helioz2000/StepAttenuator/ComponentData/Step_Att_Diminsions.pdf

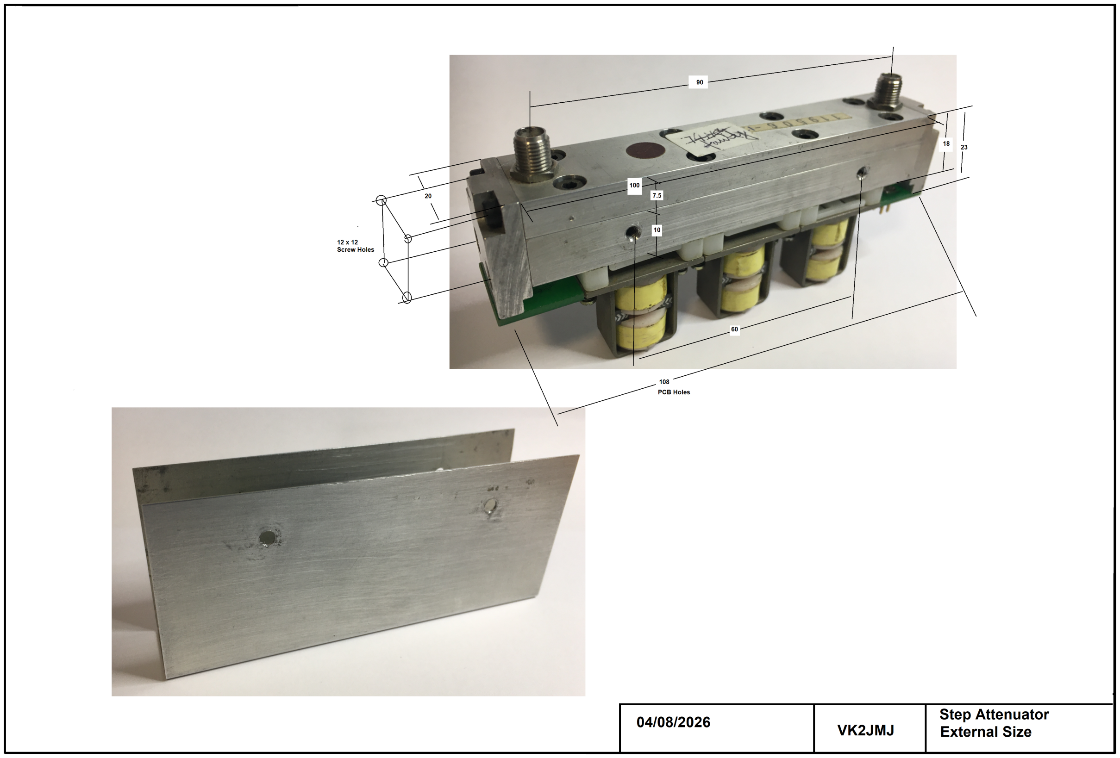
[picture p4: page 1]
