helioz2000/StepAttenuator/StepAttenuator_R0.1.pdf

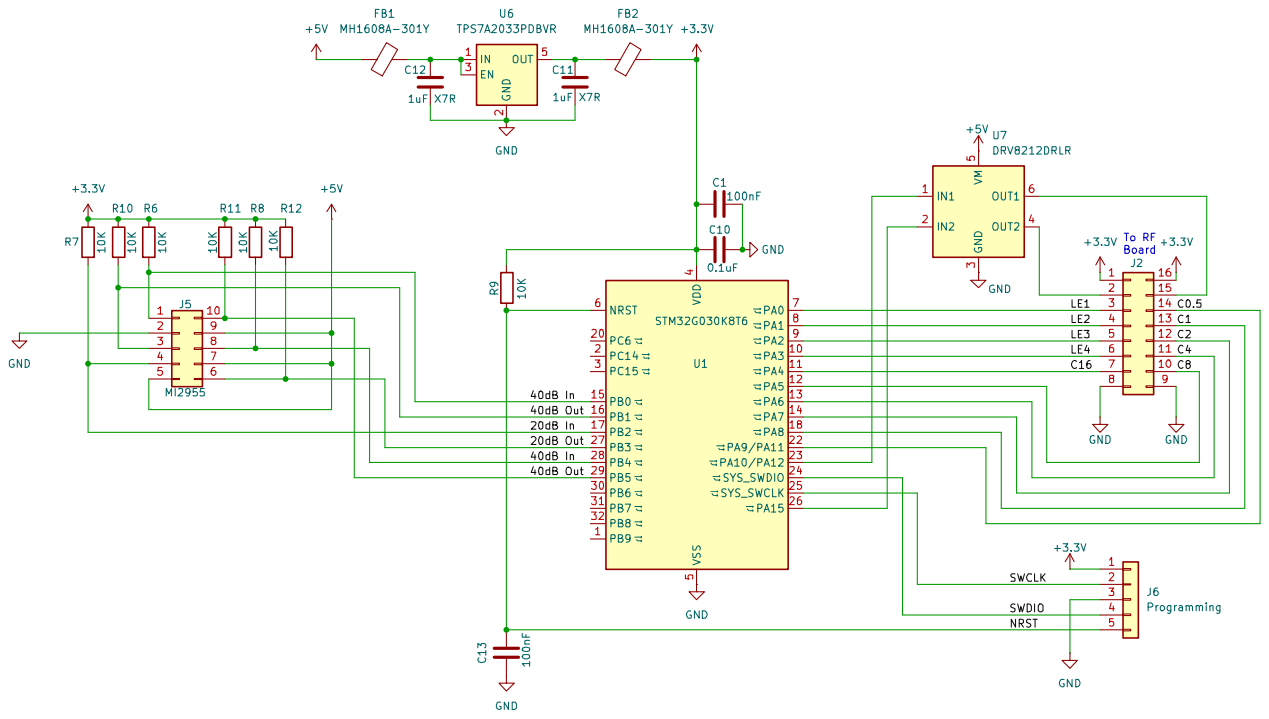
[picture p5: page 1]

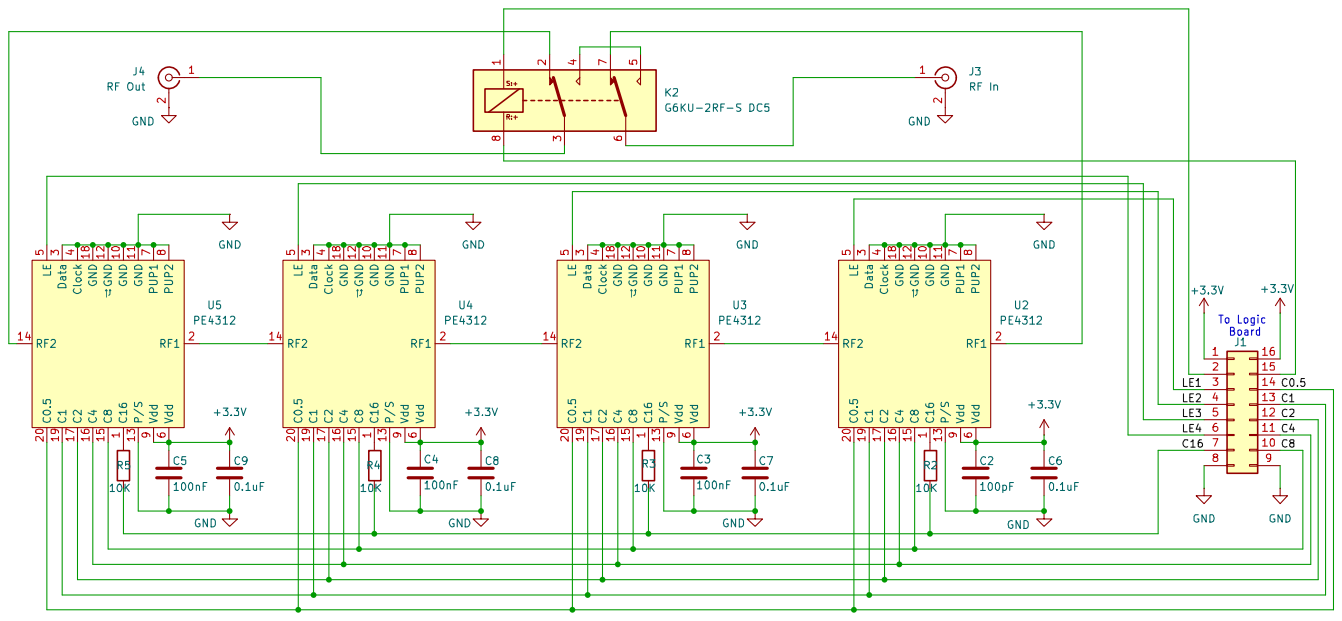
[picture p6: page 2]
