helioz2000/StepAttenuator/Doc/StepAttenuatorCircuit.pdf

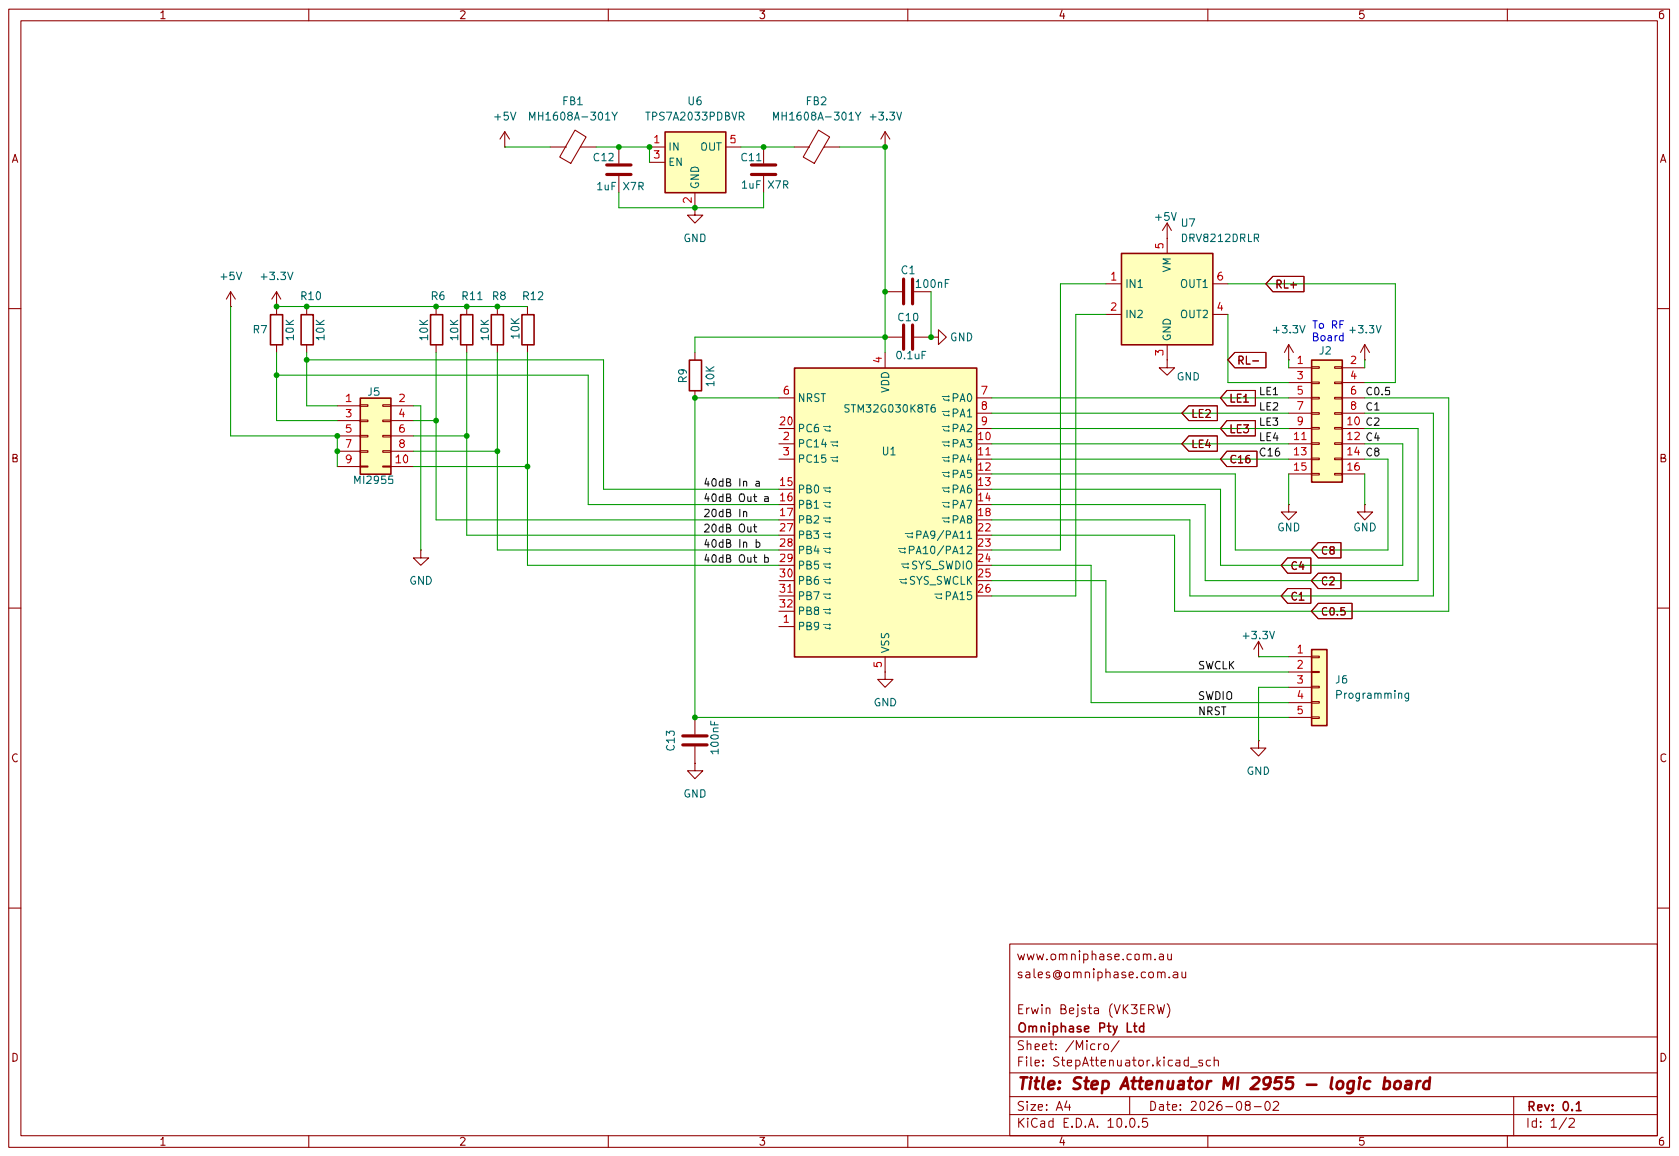
[picture p7: page 1]

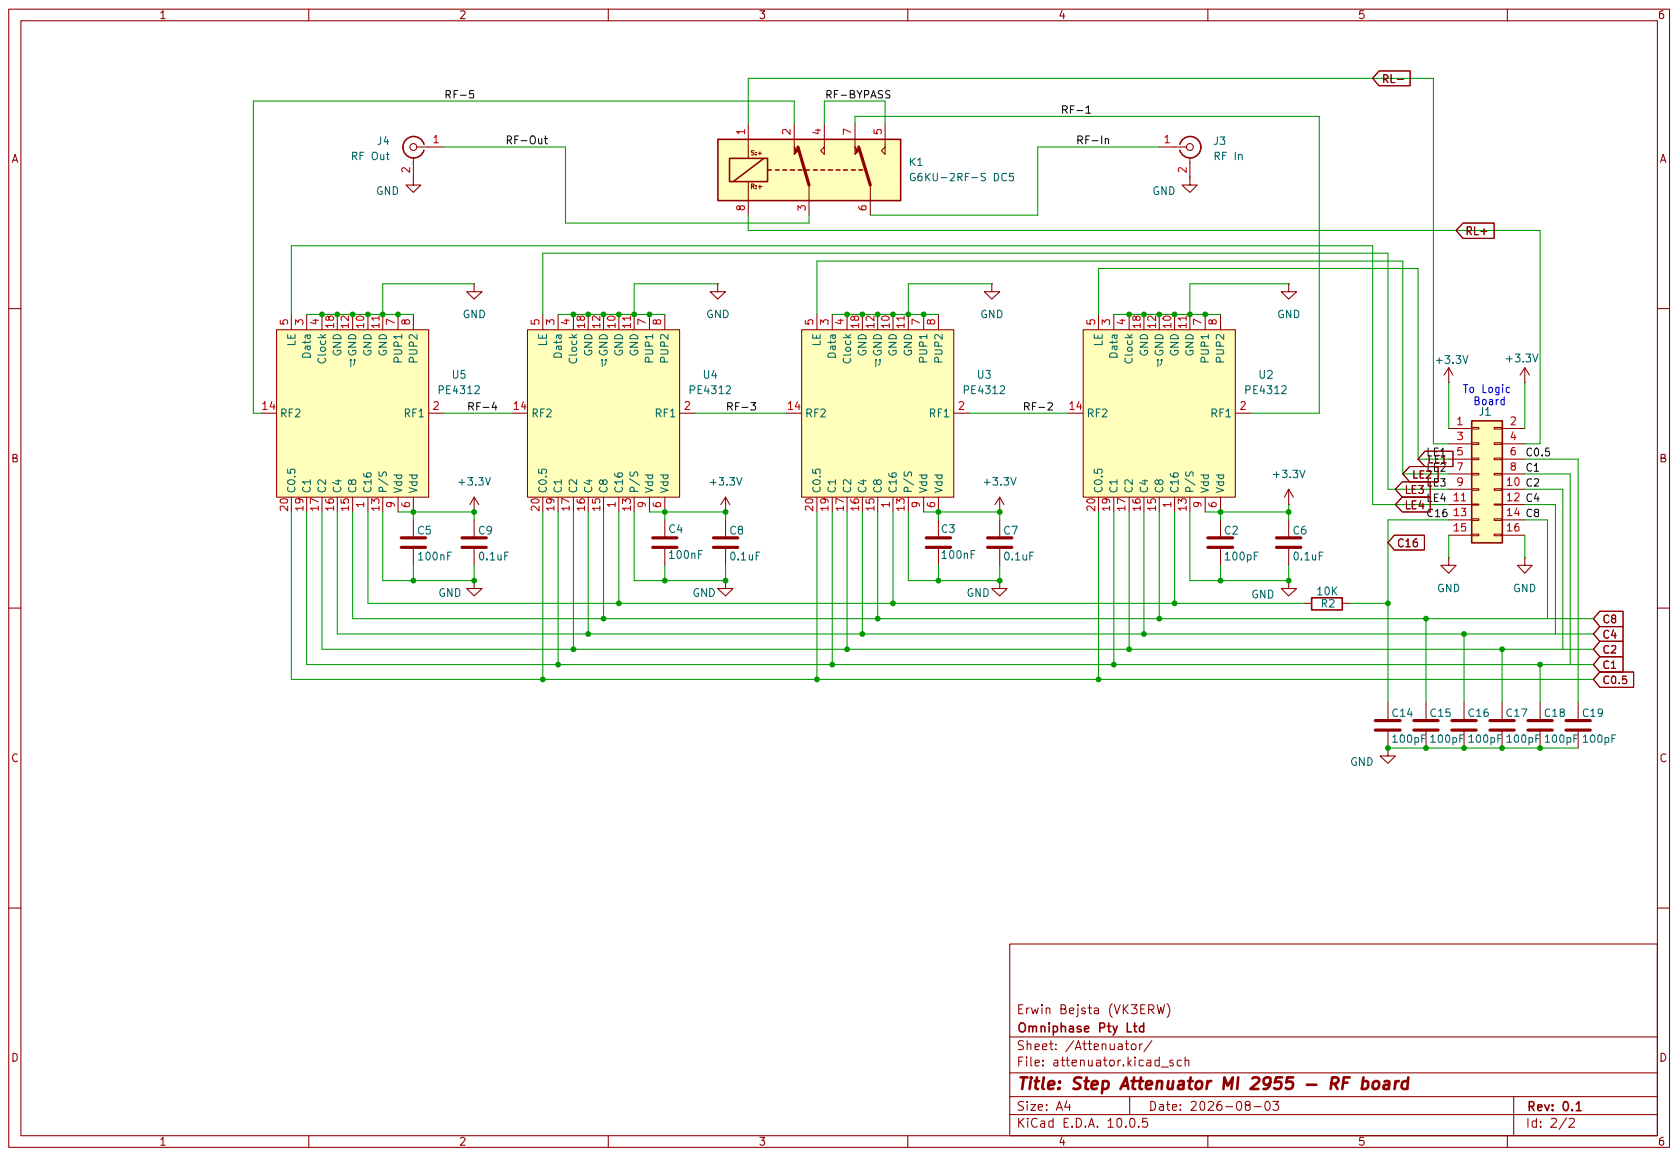
[picture p8: page 2]
