helioz2000/StepAttenuator/ComponentData/SMA_Amphenol.pdf

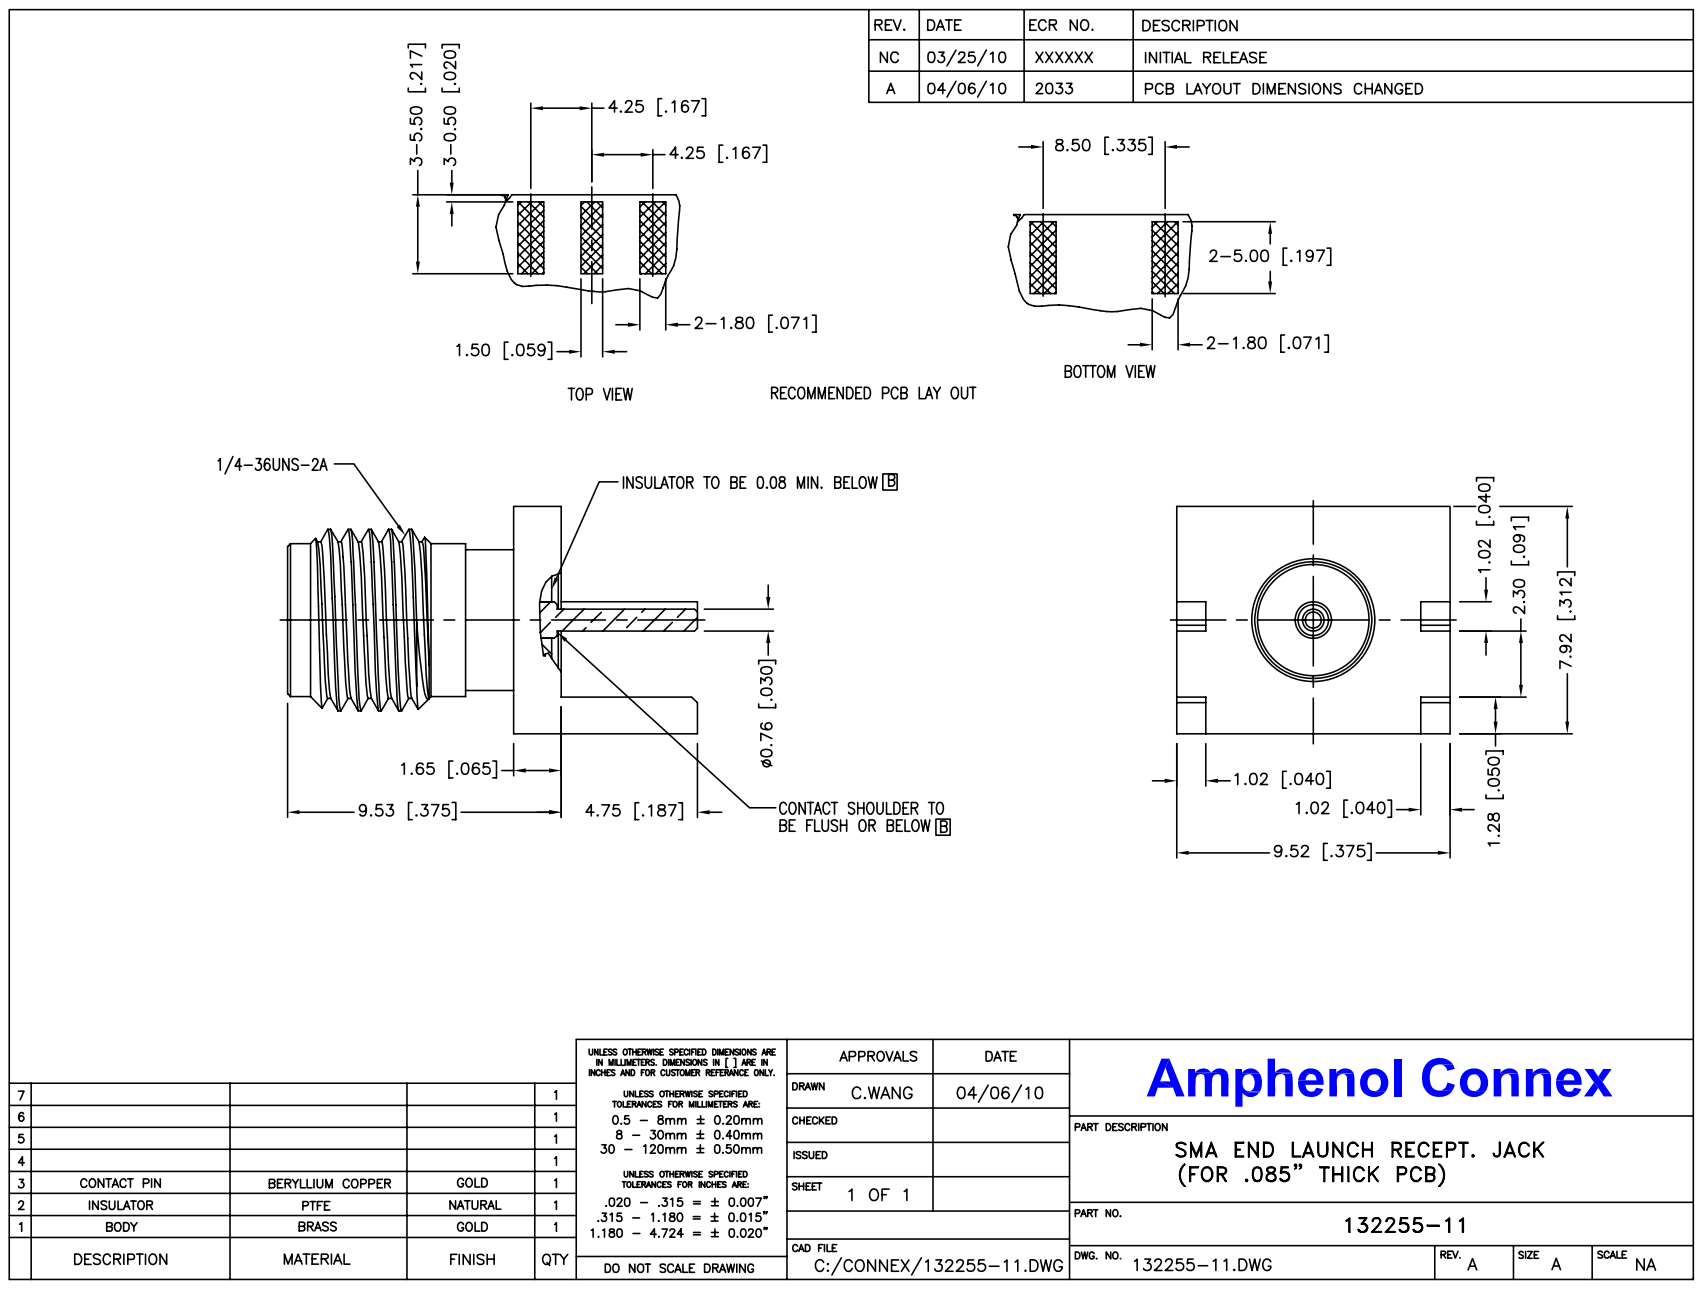
[picture p9: page 1]
