helioz2000/StepAttenuator/StepAttenuator.kicad_pcb

## KiCad design StepAttenuator.kicad_pcb (2026-10-29)

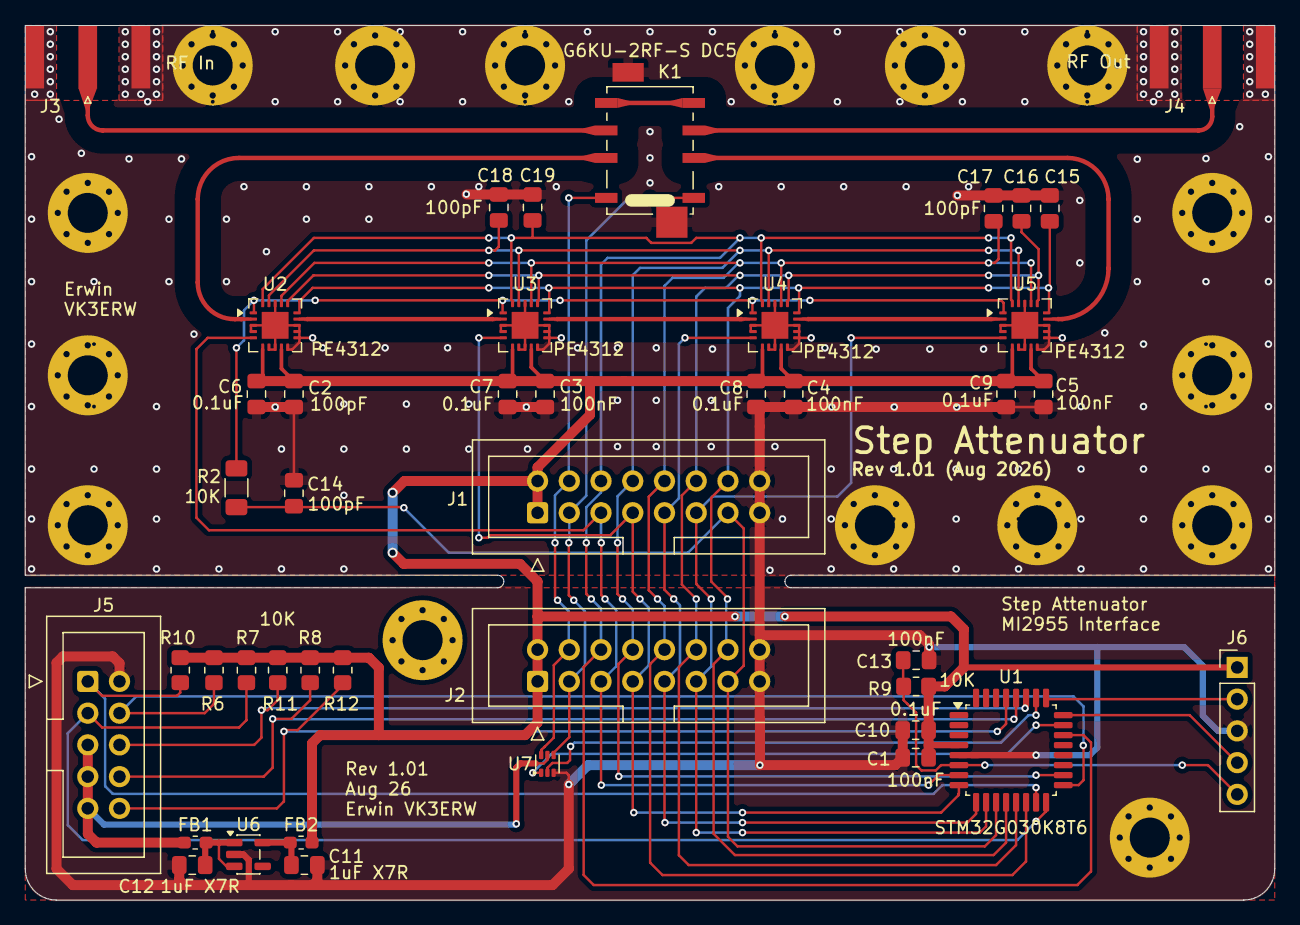
[picture p10: board StepAttenuator.kicad_pcb from above]

Board: 4 copper layers, 100.0 x 70.0 mm, 59 parts (0 on the bottom side), 37 nets.

Parts:
C1, C3, C4, C5, C13: 100nF; C_0805_2012Metric_Pad1.18x1.45mm_HandSolder
C2, C14, C15, C16, C17, C18, C19: 100pF; C_0805_2012Metric_Pad1.18x1.45mm_HandSolder
C6, C7, C8, C9, C10: 0.1uF; C_0805_2012Metric_Pad1.18x1.45mm_HandSolder
C11, C12: 1uF X7R; C_0805_2012Metric_Pad1.18x1.45mm_HandSolder
FB1, FB2: MH1608A-301Y; L_0603_1608Metric_Pad1.05x0.95mm_HandSolder
J1: IDC-Header_2x08_P2.54mm_Vertical
J2: Conn_02x08_Counter_Clockwise; IDC-Header_2x08_P2.54mm_Vertical
J3: RF In; SMA_Amphenol_132289_EdgeMount
J4: RF Out; SMA_Amphenol_132289_EdgeMount
J5: MI2955; IDC-Header_2x05_P2.54mm_Vertical
J6: Programming; PinHeader_1x05_P2.54mm_Vertical
K1: G6KU-2RF-S DC5; Relay_DPDT_Omron_G6K-2F-RF_special
M3, M3#2, M3#3, M3#4, M3#5, M3#6, M3#7, M3#8, M3#9, M3#10, M3#11, M4, M5, M6, M7, M8: MountingHole_3.2mm_M3_Pad_Via
R2: 10K; R_1206_3216Metric_Pad1.30x1.75mm_HandSolder
R6, R7, R8, R9, R10, R11, R12: 10K; R_0805_2012Metric_Pad1.20x1.40mm_HandSolder
U1: STM32G030K8T6; LQFP-32_7x7mm_P0.8mm
U2, U3, U4, U5: PE4312; QFN-20-1EP_4x4mm_P0.5mm_EP2x2mm
U6: TPS7A2033PDBVR; SOT-23-5
U7: DRV8212DRLR; SOT-563

Connections:
+3.3V: C1.1, C2.1, C3.1, C4.1, C5.1, C6.1, C7.1, C8.1, C9.1, C10.1, FB2.2, J1.1, J1.2, J2.1, J2.2, J6.1, R6.2, R7.2, R8.2, R9.1, R10.2, R11.2, R12.2, U1.4 (VDD), U2.6 (Vdd), U2.9 (Vdd), U3.6 (Vdd), U3.9 (Vdd), U4.6 (Vdd), U4.9 (Vdd), U5.6 (Vdd), U5.9 (Vdd)
+5V: FB1.1, J5.5, J5.7, J5.9, U7.5 (VM)
/Attenuator/RF-1: K1.7, U2.2 (RF1)
/Attenuator/RF-2: U2.14 (RF2), U3.2 (RF1)
/Attenuator/RF-3: U3.14 (RF2), U4.2 (RF1)
/Attenuator/RF-4: U4.14 (RF2), U5.2 (RF1)
/Attenuator/RF-5: K1.2, U5.14 (RF2)
/Attenuator/RF-BYPASS: K1.4, K1.5
/Attenuator/RF-In: J3.1 (In), K1.6
/Attenuator/RF-Out: J4.1 (In), K1.3
/Micro/20dB In: J5.4, R6.1, U1.17 (PB2)
/Micro/20dB Out: J5.6, R11.1, U1.27 (PB3)
/Micro/40dB In a: J5.1, R10.1, U1.15 (PB0)
/Micro/40dB In b: J5.8, R8.1, U1.28 (PB4)
/Micro/40dB Out a: J5.3, R7.1, U1.16 (PB1)
/Micro/40dB Out b: J5.10, R12.1, U1.29 (PB5)
/Micro/NRST: C13.2, J6.5, R9.2, U1.6 (NRST)
/Micro/SWCLK: J6.2, U1.25 (SYS_SWCLK)
/Micro/SWDIO: J6.4, U1.24 (SYS_SWDIO)
C0.5: C19.1, J1.6, J2.6, U1.22 (PA9/PA11), U2.20 (C0.5), U3.20 (C0.5), U4.20 (C0.5), U5.20 (C0.5)
C1: C18.1, J1.8, J2.8, U1.18 (PA8), U2.19 (C1), U3.19 (C1), U4.19 (C1), U5.19 (C1)
C2: C17.1, J1.10, J2.10, U1.14 (PA7), U2.17 (C2), U3.17 (C2), U4.17 (C2), U5.17 (C2)
C4: C16.1, J1.12, J2.12, U1.13 (PA6), U2.16 (C4), U3.16 (C4), U4.16 (C4), U5.16 (C4)
C8: C15.1, J1.14, J2.14, U1.12 (PA5), U2.15 (C8), U3.15 (C8), U4.15 (C8), U5.15 (C8)
C16: C14.1, J1.13, J2.13, R2.2, U1.11 (PA4)
GND: C1.2, C2.2, C3.2, C4.2, C5.2, C6.2, C7.2, C8.2, C9.2, C10.2, C11.2, C12.2, C13.1, C14.2, C15.2, C16.2, C17.2, C18.2, C19.2, J1.15, J1.16, J2.15, J2.16, J3.2 (Ext), J4.2 (Ext), J5.2, J6.3, K1.9, M3.1, M3#2.1, M3#3.1, M3#4.1, M3#5.1, M3#6.1, M3#7.1, M3#8.1, M3#9.1, M3#10.1, M4.1, M5.1, M6.1, M7.1, M8.1, U1.5 (VSS), U2.3 (Data), U2.4 (Clock), U2.7 (PUP1), U2.8 (PUP2), U2.10 (GND), U2.11 (GND), U2.12 (GND), U2.13 (P/S), U2.18 (GND), U2.21, U3.3 (Data), U3.4 (Clock), U3.7 (PUP1), U3.8 (PUP2), U3.10 (GND), U3.11 (GND), U3.12 (GND), U3.13 (P/S), U3.18 (GND), U3.21, U4.3 (Data), U4.4 (Clock), U4.7 (PUP1), U4.8 (PUP2), U4.10 (GND), U4.11 (GND), U4.12 (GND), U4.13 (P/S), U4.18 (GND), U4.21, U5.3 (Data), U5.4 (Clock), U5.7 (PUP1), U5.8 (PUP2), U5.10 (GND), U5.11 (GND), U5.12 (GND), U5.13 (P/S), U5.18 (GND), U5.21, U6.2 (GND), U7.3 (GND)
LE1: J1.5, J2.5, U1.7 (PA0), U2.5 (LE)
LE2: J1.7, J2.7, U1.8 (PA1), U3.5 (LE)
LE3: J1.9, J2.9, U1.9 (PA2), U4.5 (LE)
LE4: J1.11, J2.11, U1.10 (PA3), U5.5 (LE)
unnamed: U1.23 (PA10/PA12), U7.1 (IN1)
unnamed: U1.26 (PA15), U7.2 (IN2)
unnamed: R2.1, U2.1 (C16), U3.1 (C16), U4.1 (C16), U5.1 (C16)
unnamed: C12.1, FB1.2, U6.1 (IN), U6.3 (EN)
unnamed: C11.1, FB2.1, U6.5 (OUT)
RL+: J1.4, J2.4, K1.8, U7.6 (OUT1)
RL-: J1.3, J2.3, K1.1, U7.4 (OUT2)
