helioz2000/StepAttenuator/STM32/StepAttenuator/Core/Src/main.c

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
/* Includes ------------------------------------------------------------------*/
#include "main.h"
#include "usart.h"
#include "gpio.h"

/* USER CODE BEGIN Includes */
#include <stdbool.h>
#include <stdio.h>
/* USER CODE END Includes */

/* USER CODE BEGIN PD */
#define PE4312_TIME 1	// [ms] delay between signal changes on the pads
#define SERVICE_SIGNAL_DEBOUNCE 200 // [ms] debounce time for Service Mode signals
/* USER CODE END PD */


/* USER CODE BEGIN PV */
// Volatile declaration for access in ISR and main program
volatile bool Att40A_state = false;
volatile bool Att40B_state = false;
volatile bool Att20_state = false;
volatile bool AttStateChanged = false;
volatile bool ServiceMode = false;				// Service mode for manual control
volatile bool ServiceModeInc = false;			// Service mode value increment
volatile bool ServiceModeDec = false;			// Service mode value decrement
volatile bool ServiceModeBypass = false;		// Service mode bypass enable
volatile bool ServiceModeBypassChanged = false;
bool ServicePE1 = false;
bool ServicePE2 = false;
bool ServicePE3 = false;
bool ServicePE4 = false;
int ServiceValue = 0;
volatile uint32_t ServiceLast_exti_time = 0;
/*
 * This matrix represents the attenuation settings for each of the 4 pad
 * in the attenuation circuit.
 * Power dissipation %age per pad is shown in line comments.
 * The maximum power dissipation per pad is +24dBm
 * At 100dB total attenuation the max input power to the
 * attenuator is +26.74dBm (472mW)
 *
 * NOTE: each attenuator pad has a typical insertion loss of 1.3dB (<1gHz) which
 * is taken into account in the below configuration. The attenuation
 * figures in brackets in the line comment represent attenuation
 * including the pad insertion losses
*/
const int ATTENUATOR_MATRIX[6][4] = {
    {  0,   0,   0,   0},  // 0dB: bypass via relay (total insertion loss of pads is 5.2dB)
    {  0,   5,  15, 130},  // 20.2dB  25.9%, 25.1%, 23.3%, 24.7% (1.3dB,1.8dB,2.8dB,14.3dB)
    {  0,  10,  30, 310},  // 40.2dB: 25.9%, 3.5%, 27.4%, 16.2% (1.3dB,2.3dB,4.3dB,32.3dB)
    {  5,  15, 220, 310},  // 60.2dB: 33.9%, 31.4%, 34.5%, 0.2% (1.8dB,2.8dB,23.3dB,32.3dB
    { 15, 105, 310, 310},  // 80.2dB: 47.5%, 49.7%, 2.7%, 0% (2.8dB,11.5dB,32.3dB,32.3dB)
    { 20, 310, 310, 310}   // 100.2dB: 53.2%, 46.7%, 0%, 0% (3.3dB,32.3dB,32.3dB,32.3dB)
/*	figures without pad insertion loss
    { 10,  15,  30, 145},  // 20dB  20.6%, 23.2%, 28%, 27.2%
    { 15,  25,  50, 310},  // 40dB: 29.2%, 31%, 27.2%, 12.6%
    { 15,  30, 245, 310},  // 60dB: 29.2%, 35.3%, 35.3%, 0.2%
    { 30, 150, 310, 310},  // 80dB: 49.9%, 48.5%, 1.6%, 0%
    { 70, 310, 310, 310}   // 100dB: 80%, 20%, 0%, 0%
*/
};

/* USER CODE END PV */

void SystemClock_Config(void);
/* USER CODE BEGIN 0 */

/**
  * @brief  Redirects standard output (printf) to the USART1 peripheral.
  * @param  file: Not used in this implementation.
  * @param  ptr: Pointer to the string buffer to transmit.
  * @param  len: Length of the string data to transmit.
  * @retval Number of characters transmitted.
  */
int _write(int file, char *ptr, int len)
{
  // External reference to the UART handle generated by CubeMX
  extern UART_HandleTypeDef huart1;

  // Transmit data over USART1 with a safe 100ms timeout window
  HAL_UART_Transmit(&huart1, (uint8_t*)ptr, len, 100);

  return len;
}

/**
 * @brief  Print service mode selected attenuator
 */
void print_service_mode_PE(void)
{
	if (ServicePE1) {
		printf("ATT1(U2)");
	} else if (ServicePE2){
		printf("ATT2(U3)");
	} else if (ServicePE3){
		printf("ATT3(U4)");
	} else if (ServicePE4){
		printf("ATT4(U5)");
	}
}

/**
 * @brief  Handle button interrupt in service mode
 */
void HAL_GPIO_EXTI_ServiceMode(uint16_t GPIO_Pin){
  uint32_t current_time = HAL_GetTick();
  // debounce service mode signals by ignoring signals for debounce time
  if ((current_time - ServiceLast_exti_time) < SERVICE_SIGNAL_DEBOUNCE) return;

  if (GPIO_Pin == ATT40A_IN_Pin)
  {
	ServiceModeInc = true;
  } else if (GPIO_Pin == ATT40A_OUT_Pin)
  {
	ServiceModeDec = true;
  } else if (GPIO_Pin == ATT20_IN_Pin)
  {
	ServiceModeBypass = !ServiceModeBypass;
	ServiceModeBypassChanged = true;
  }
  ServiceLast_exti_time = HAL_GetTick();
}

/**
 * @brief  Callback when attenuator setting inputs change
 */
void HAL_GPIO_EXTI_Falling_Callback(uint16_t GPIO_Pin)
{
  if (!ServiceMode) {
	if (GPIO_Pin == ATT40A_IN_Pin)
	{
		if (Att40A_state != true) AttStateChanged = true;
	    Att40A_state = true;
	} else if (GPIO_Pin == ATT40A_OUT_Pin)
	{
	    if (Att40A_state != false) AttStateChanged = true;
	    Att40A_state = false;
	} else if (GPIO_Pin == ATT20_IN_Pin)
	{
		if (Att20_state != true) AttStateChanged = true;
	    Att20_state = true;
	} else if (GPIO_Pin == ATT20_OUT_Pin)
	{
		if (Att20_state != false) AttStateChanged = true;
		Att20_state = false;
	} else if (GPIO_Pin == ATT40B_IN_Pin)
	{
		if (Att40B_state != true) AttStateChanged = true;
		Att40B_state = true;
	} else if (GPIO_Pin == ATT40B_OUT_Pin)
	{
		if (Att40B_state != false) AttStateChanged = true;
		Att40B_state = false;
	}
  } else {	// Service mode active
	  HAL_GPIO_EXTI_ServiceMode(GPIO_Pin);
  }
}

/**
 * @brief	Put MCU into stop mode until wake up by External Interrupt
 * @note	Upon wake up the MCU executes the ISR before code resumption
 */
void MCU_stop()
{
	/* Clear any pending flags and prepare for sleep */
	// It is good practice to wait for any signals to be fully released
	// so you don't instantly re-wake up from a lingering touch.
	HAL_Delay(500);

	/* ENTER DEEP SLEEP (STOP MODE) */
	/* This command drops current consumption to micro-amps.
       Execution pauses here until PB0-PB5 triggers an interrupt. */
	HAL_PWR_EnterSTOPMode(PWR_LOWPOWERREGULATOR_ON, PWR_STOPENTRY_WFI);

	/* When execution resumes after MCU stop, the interrupt service routine (ISR)
	 * will be executed before resuming execution at this point */

	/* IMPORTANT: RESTORE SYSTEM CLOCKS IMMEDIATELY AFTER WAKING UP */
	/* When waking from STOP mode, the STM32G0 always defaults back to
	   its internal HSI clock (16 MHz) and disables your high-speed PLL.
	   You must call this function to safely rebuild your clock tree back to
	   your configured speed (e.g., 64 MHz). */
	SystemClock_Config();

    /* Handle any post-wakeup operations */
	// Code here executes immediately after the clock is restored

}

/**
  * @brief  Set attenuator bypass relay
  * @param attValue: attenuator setpoint in dB
  */
void attenuator_bypass_relay(int attValue){
	//Switch relay into ON/OFF state
	if (attValue == 0) {
		HAL_GPIO_WritePin(RLY_ON_GPIO_Port, RLY_ON_Pin, GPIO_PIN_SET);
		HAL_GPIO_WritePin(RLY_OFF_GPIO_Port, RLY_OFF_Pin, GPIO_PIN_RESET);
	} else {
		HAL_GPIO_WritePin(RLY_ON_GPIO_Port, RLY_ON_Pin, GPIO_PIN_RESET);
		HAL_GPIO_WritePin(RLY_OFF_GPIO_Port, RLY_OFF_Pin, GPIO_PIN_SET);
	}
	// Time for relay to resume new position
	HAL_Delay(200);
	// The relay will stay in position without power
	HAL_GPIO_WritePin(RLY_ON_GPIO_Port, RLY_ON_Pin, GPIO_PIN_RESET);
	HAL_GPIO_WritePin(RLY_OFF_GPIO_Port, RLY_OFF_Pin, GPIO_PIN_RESET);
}

/**
  * @brief  Set attenuator value on parallel control lines
  * @param attValue: pad set point in dB x 10
  * @retval True on success
  */
// Pad attenuation range is 0-31.5dB in 0.5dB steps
bool attenuator_set_value(int attValue)
{
	// range check
	if ((attValue > 315) || (attValue < 0)) { return false; }
	int att = attValue;
	if (att >= 160) {
		HAL_GPIO_WritePin(C16_GPIO_Port, C16_Pin, GPIO_PIN_SET);
		att -= 160;
	} else {
		HAL_GPIO_WritePin(C16_GPIO_Port, C16_Pin, GPIO_PIN_RESET);
	}
	if (att >= 80) {
		HAL_GPIO_WritePin(C16_GPIO_Port, C8_Pin, GPIO_PIN_SET);
		att -= 80;
	} else {
		HAL_GPIO_WritePin(C16_GPIO_Port, C8_Pin, GPIO_PIN_RESET);
	}
	if (att >= 40) {
		HAL_GPIO_WritePin(C16_GPIO_Port, C4_Pin, GPIO_PIN_SET);
		att -= 40;
	} else {
		HAL_GPIO_WritePin(C16_GPIO_Port, C4_Pin, GPIO_PIN_RESET);
	}
	if (att >= 20) {
		HAL_GPIO_WritePin(C16_GPIO_Port, C2_Pin, GPIO_PIN_SET);
		att -= 20;
	} else {
		HAL_GPIO_WritePin(C16_GPIO_Port, C2_Pin, GPIO_PIN_RESET);
	}
	if (att >= 10) {
		HAL_GPIO_WritePin(C16_GPIO_Port, C1_Pin, GPIO_PIN_SET);
		att -= 10;
	} else {
		HAL_GPIO_WritePin(C16_GPIO_Port, C1_Pin, GPIO_PIN_RESET);
	}
	if (att >= 5) {
		HAL_GPIO_WritePin(C16_GPIO_Port, C05_Pin, GPIO_PIN_SET);
		att -= 5;
	} else {
		HAL_GPIO_WritePin(C16_GPIO_Port, C05_Pin, GPIO_PIN_RESET);
	}

    return true;
}

/**
  * @brief  Set attenuator pads to correct value
  * @param attValue: attenuator total attenuation in dB
  */
void attenuator_set_pads(int attValue) {
	// Possible values: 0, 20, 40, 60, 80, 100
	// Convert to array index 0,1,2,3,4,5
	int attIndex = attValue/20;
	// All latch signals off
	HAL_GPIO_WritePin(LE1_GPIO_Port, LE1_Pin, GPIO_PIN_RESET);
	HAL_GPIO_WritePin(LE2_GPIO_Port, LE2_Pin, GPIO_PIN_RESET);
	HAL_GPIO_WritePin(LE3_GPIO_Port, LE3_Pin, GPIO_PIN_RESET);
	HAL_GPIO_WritePin(LE4_GPIO_Port, LE4_Pin, GPIO_PIN_RESET);
	HAL_Delay(PE4312_TIME);

	// Attenuator Pad 1
	attenuator_set_value(ATTENUATOR_MATRIX[attIndex][0]);
	HAL_Delay(PE4312_TIME);
	// latch value into pad
	HAL_GPIO_WritePin(LE1_GPIO_Port, LE1_Pin, GPIO_PIN_SET);
	HAL_Delay(PE4312_TIME);
	HAL_GPIO_WritePin(LE1_GPIO_Port, LE1_Pin, GPIO_PIN_RESET);

	// Attenuator Pad 2
	attenuator_set_value(ATTENUATOR_MATRIX[attIndex][1]);
	HAL_Delay(PE4312_TIME);
	// latch value into pad
	HAL_GPIO_WritePin(LE2_GPIO_Port, LE2_Pin, GPIO_PIN_SET);
	HAL_Delay(PE4312_TIME);
	HAL_GPIO_WritePin(LE2_GPIO_Port, LE2_Pin, GPIO_PIN_RESET);

	// Attenuator Pad 3
	attenuator_set_value(ATTENUATOR_MATRIX[attIndex][2]);
	HAL_Delay(PE4312_TIME);
	// latch value into pad
	HAL_GPIO_WritePin(LE3_GPIO_Port, LE3_Pin, GPIO_PIN_SET);
	HAL_Delay(PE4312_TIME);
	HAL_GPIO_WritePin(LE3_GPIO_Port, LE3_Pin, GPIO_PIN_RESET);

	// Attenuator Pad 4
	attenuator_set_value(ATTENUATOR_MATRIX[attIndex][3]);
	HAL_Delay(PE4312_TIME);
	// latch value into pad
	HAL_GPIO_WritePin(LE4_GPIO_Port, LE4_Pin, GPIO_PIN_SET);
	HAL_Delay(PE4312_TIME);
	HAL_GPIO_WritePin(LE4_GPIO_Port, LE4_Pin, GPIO_PIN_RESET);
}

/**
  * @brief  Set attenuator pad service value on service pad
  */
void attenuator_set_service(void) {
	// All latch signals off
	HAL_GPIO_WritePin(LE1_GPIO_Port, LE1_Pin, GPIO_PIN_RESET);
	HAL_GPIO_WritePin(LE2_GPIO_Port, LE2_Pin, GPIO_PIN_RESET);
	HAL_GPIO_WritePin(LE3_GPIO_Port, LE3_Pin, GPIO_PIN_RESET);
	HAL_GPIO_WritePin(LE4_GPIO_Port, LE4_Pin, GPIO_PIN_RESET);
	HAL_Delay(PE4312_TIME);

	attenuator_set_value(ServiceValue);
	if (ServicePE1) {
		HAL_GPIO_WritePin(LE1_GPIO_Port, LE1_Pin, GPIO_PIN_SET);
		HAL_Delay(PE4312_TIME);
		HAL_GPIO_WritePin(LE1_GPIO_Port, LE1_Pin, GPIO_PIN_RESET);
	} else if (ServicePE2)
	{
		HAL_GPIO_WritePin(LE2_GPIO_Port, LE2_Pin, GPIO_PIN_SET);
		HAL_Delay(PE4312_TIME);
		HAL_GPIO_WritePin(LE2_GPIO_Port, LE2_Pin, GPIO_PIN_RESET);
	} else if (ServicePE3)
	{
		HAL_GPIO_WritePin(LE3_GPIO_Port, LE3_Pin, GPIO_PIN_SET);
		HAL_Delay(PE4312_TIME);
		HAL_GPIO_WritePin(LE3_GPIO_Port, LE3_Pin, GPIO_PIN_RESET);
	} else if (ServicePE4)
	{
		HAL_GPIO_WritePin(LE4_GPIO_Port, LE4_Pin, GPIO_PIN_SET);
		HAL_Delay(PE4312_TIME);
		HAL_GPIO_WritePin(LE4_GPIO_Port, LE4_Pin, GPIO_PIN_RESET);
	}
	HAL_Delay(PE4312_TIME);
}

/**
  * @brief  Set attenuation in accordance with attenuator state
  */
void attenuator_set(void)
{
	int attValue = 0;
	// Calculate total attenuation
	if (Att40A_state) attValue += 40;
	if (Att40B_state) attValue += 40;
	if (Att20_state) attValue += 20;
	// Set bypass relay
	attenuator_bypass_relay(attValue);
	// set all attenuator pads
	attenuator_set_pads(attValue);
}

/* USER CODE END 0 */

/**
  * @brief  The application entry point.
  * @retval int
  */
int main(void)
{

  /* MCU Configuration--------------------------------------------------------*/

  /* Reset of all peripherals, Initializes the Flash interface and the Systick. */
  HAL_Init();

  /* Configure the system clock */
  SystemClock_Config();

  /* Initialize all configured peripherals */
  MX_GPIO_Init();
  MX_USART1_UART_Init();
  /* USER CODE BEGIN 2 */

  // Check for service mode (ATT40A_IN and ATT40A_OUT activated [low])
  // Other inputs to select attenuator pad to test
  if (HAL_GPIO_ReadPin(ATT40A_IN_GPIO_Port, ATT40A_IN_Pin) == GPIO_PIN_RESET)
  {
    if (HAL_GPIO_ReadPin(ATT40A_OUT_GPIO_Port, ATT40A_OUT_Pin) == GPIO_PIN_RESET)
    {
      ServiceMode = true;
      printf("Service Mode selected - release buttons\r\n");
	  if (HAL_GPIO_ReadPin(ATT20_IN_GPIO_Port, ATT20_IN_Pin) == GPIO_PIN_RESET)
	  {
      ServicePE1 = true;
	  } else if (HAL_GPIO_ReadPin(ATT20_OUT_GPIO_Port, ATT20_OUT_Pin) == GPIO_PIN_RESET)
	  {
	    ServicePE2 = true;
	  } else if (HAL_GPIO_ReadPin(ATT40B_IN_GPIO_Port, ATT40B_IN_Pin) == GPIO_PIN_RESET)
	  {
	    ServicePE3 = true;
	  } else if (HAL_GPIO_ReadPin(ATT40B_OUT_GPIO_Port, ATT40B_OUT_Pin) == GPIO_PIN_RESET)
	  {
	    ServicePE4 = true;
	  } else {
	  	ServicePE1 = true;	// in case 3rd button is not pressed
	  }
	  // Set bypass relay off
	  attenuator_bypass_relay(100);
	  // set all attenuator pads to 0dB
	  attenuator_set_pads(0);
    }
    // Wait for service mode trigger to be released
    while (1)
    {
      if (HAL_GPIO_ReadPin(ATT40A_IN_GPIO_Port, ATT40A_IN_Pin) == GPIO_PIN_SET) {
    	  if (HAL_GPIO_ReadPin(ATT40A_OUT_GPIO_Port, ATT40A_OUT_Pin) == GPIO_PIN_SET) {
    		break;
    	  }
      }
    }
    print_service_mode_PE();
    printf(" Service\r\n");
    HAL_Delay(200); 	// Let inputs settle.
  }
  /* USER CODE END 2 */

  /* Infinite loop */
  /* USER CODE BEGIN WHILE */
  while (1)
  {
	if (!ServiceMode)
	// Normal operation mode
	{
		// change attenuator setting
		if (AttStateChanged)
		{
		  attenuator_set();
		  AttStateChanged = false;
		}
		MCU_stop();
	} else
	// Service Mode
	{
	  // Bypass relay
	  if (ServiceModeBypassChanged) {
	    ServiceModeBypassChanged = false;
	    attenuator_bypass_relay(!ServiceModeBypass);
	    printf("Bypass relay: %d\r\n", ServiceModeBypass);
	  }
	  if (ServiceModeInc) {
	  	if (ServiceValue <= 310) ServiceValue += 5;
	  	else ServiceValue = 0;
	  	ServiceModeInc = false;
	  	print_service_mode_PE();
	  	printf(" %d dB x 10", ServiceValue);
	  	attenuator_set_service();
	  }
	  if (ServiceModeDec) {
	  	if (ServiceValue >= 5) ServiceValue -= 5;
	  	else ServiceValue = 315;
	  	ServiceModeDec = false;
	  	print_service_mode_PE();
	  	printf(" %d dB x 10", ServiceValue);
	  	attenuator_set_service();
	  }
		HAL_Delay(10);
	}
    /* USER CODE END WHILE */

    /* USER CODE BEGIN 3 */
  }
  /* USER CODE END 3 */
}

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
