helioz2000/StepAttenuator/STM32/StepAttenuator/Core/Inc/main.h

#define LE1_Pin GPIO_PIN_0
#define LE1_GPIO_Port GPIOA
#define LE2_Pin GPIO_PIN_1
#define LE2_GPIO_Port GPIOA
#define LE3_Pin GPIO_PIN_2
#define LE3_GPIO_Port GPIOA
#define LE4_Pin GPIO_PIN_3
#define LE4_GPIO_Port GPIOA
#define C16_Pin GPIO_PIN_4
#define C16_GPIO_Port GPIOA
#define C8_Pin GPIO_PIN_5
#define C8_GPIO_Port GPIOA
#define C4_Pin GPIO_PIN_6
#define C4_GPIO_Port GPIOA
#define C2_Pin GPIO_PIN_7
#define C2_GPIO_Port GPIOA
#define ATT40A_IN_Pin GPIO_PIN_0
#define ATT40A_IN_GPIO_Port GPIOB
#define ATT40A_IN_EXTI_IRQn EXTI0_1_IRQn
#define ATT40A_OUT_Pin GPIO_PIN_1
#define ATT40A_OUT_GPIO_Port GPIOB
#define ATT40A_OUT_EXTI_IRQn EXTI0_1_IRQn
#define ATT20_IN_Pin GPIO_PIN_2
#define ATT20_IN_GPIO_Port GPIOB
#define ATT20_IN_EXTI_IRQn EXTI2_3_IRQn
#define C1_Pin GPIO_PIN_8
#define C1_GPIO_Port GPIOA
#define C05_Pin GPIO_PIN_11
#define C05_GPIO_Port GPIOA
#define RLY_OFF_Pin GPIO_PIN_12
#define RLY_OFF_GPIO_Port GPIOA
#define RLY_ON_Pin GPIO_PIN_15
#define RLY_ON_GPIO_Port GPIOA
#define ATT20_OUT_Pin GPIO_PIN_3
#define ATT20_OUT_GPIO_Port GPIOB
#define ATT20_OUT_EXTI_IRQn EXTI2_3_IRQn
#define ATT40B_IN_Pin GPIO_PIN_4
#define ATT40B_IN_GPIO_Port GPIOB
#define ATT40B_IN_EXTI_IRQn EXTI4_15_IRQn
#define ATT40B_OUT_Pin GPIO_PIN_5
#define ATT40B_OUT_GPIO_Port GPIOB
#define ATT40B_OUT_EXTI_IRQn EXTI4_15_IRQn
